nycocado/wash-buddy/media/milestone-2/bom-d01.xlsx

Ref. Fabricante | Descrição | Categoria | Quant. | Preço un. | Sub-total | Distribuidor | URL | Dimensão (mm)
ESP32-C3 | Microcontrolador ESP32-C3 | Microcontrolador | 1 | €5.58 | €5.58 | Amazon | https://www.amazon.es/-/pt/dp/B0DMNBWTFD | 22,5 x 18
BF350-3AA | Sensor de Tensão Variável - Strain Gauges | Sensor | 10 | €1.09 | €10.86 | Amazon | https://www.amazon.es/-/pt/dp/B07TVHSKD1 | 7,1 x 4,5
742548981693 | Amplificador HX711 | Conversor Analógico-Digital | 1 | €5.07 | €5.07 | Amazon | https://www.amazon.es/-/pt/dp/B07DK1SRPM (https://www.amazon.es/-/pt/dp/B07DK1SRPM/ref=sr_1_10?s=industrial) | 24 x 16
26 | Giroscópio/Acelerómetro MPU-6050 | Sensor | 1 | €4.57 | €4.57 | Amazon | https://www.amazon.es/-/pt/dp/B0CW5144RT (https://www.amazon.es/-/pt/dp/B0CW5144RT?s=industrial) | 20 x 15
096-7357 | Motor de Vibração de Pastilha 3v | Atuadores | 1 | €1.09 | €1.09 | Mauser | https://mauser.pt/096-7357 (https://mauser.pt/096-7357/mini-motor-de-vibracao-de-pastilha-3v-10x2mm) | Ø 10 x 2
035-5293 | Bateria 3.7V 1200mAh Li-Po | Alimentação | 1 | €7.45 | €7.45 | Mauser | https://mauser.pt/035-5293 (https://mauser.pt/035-5293/bateria-3-7v-1200mah-li-po-34x40x8-8mm) | 34 x 40 x 8,8
B0D8Q7NG96 | Módulo de Carregamento de Bateria 5V | Carregador de Bateria | 1 | €5.37 | €5.37 | Amazon | https://www.amazon.es/-/pt/dp/B0D8Q7NG96 (https://www.amazon.es/-/pt/dp/B0D8Q7NG96/ref=sr_1_6) | 25 x 19
R915 | USB-C Fêmea Resistênte a Água | USB-C Entrada | 1 | €1.25 | €1.25 | Amazon | https://www.amazon.es/-/pt/dp/B0CDBZZQBZ (https://www.amazon.es/-/pt/dp/B0CDBZZQBZ/ref=sr_1_3) | 25 x 19 x 10
BJ-RS-25VALUES-1000PCS | Resistor 1kΩ | Eletrônica | 1 | €0.01 | €0.01 | Amazon | https://www.amazon.es/-/pt/dp/B08FD1XVL6 (https://www.amazon.es/-/pt/dp/B08FD1XVL6/ref=sr_1_6) | 7,1 x 4,5
BJ-RS-25VALUES-1000PCS | Resistor 10kΩ | Eletrônica | 1 | €0.01 | €0.01 | Amazon | https://www.amazon.es/-/pt/dp/B08FD1XVL6 (https://www.amazon.es/-/pt/dp/B08FD1XVL6/ref=sr_1_6) | 6,5 x 2,3
004-0601 | Capacitor 10μF | Eletrônica | 1 | €0.18 | €0.18 | Mauser | https://mauser.pt/004-0601 (https://mauser.pt/004-0601/condensador-electrolitico-10uf-25v-85-5x11mm) | < 5 mm de diâmetro
007-0205 | Diodo Comutação 100V 200mA | Eletrônica | 1 | €0.09 | €0.09 | Mauser | https://mauser.pt/007-0205 (https://mauser.pt/007-0205/diodo-comutacao-100v-200ma-1n4148-sod27-do-35) | 6,5 x 2,3
002-0093 | Transistor 2N2222A | Eletrônica | 1 | €0.69 | €0.69 | Mauser | https://mauser.pt/002-0093 (https://mauser.pt/002-0093/transistor-2n2222a-to92) | 4,5 x 4,5
096-8739 | Módulo Step-Up XL6009 | Alimentação | 1 | €1.96 | €1.96 | Mauser | https://mauser.pt/096-8739 (https://mauser.pt/096-8739/modulo-step-up-boost-ajustavel-xl6009-5-35v-4a) | 49 x 23,5 x 12,5
096-8736 | Display LCD OLED 0,91" 128x32 | Display | 1 | €3.46 | €3.46 | Mauser | https://mauser.pt/096-8736 | 38 x 12
 |  |  |  | Sub-Total | €47.65
 |  |  |  | Total | €47.65
