nycocado/wash-buddy/media/milestone-2/bom-d02.xlsx

Ref. Fabricante | Descrição | Categoria | Quant. | Preço un. | Sub-total | Distribuidor | URL
‎AM03DE-GXFB0014-005 | Microcontrolador ESP32-WROOM-32 | Microcontrolador | 1 | €7.11 | €7.11 | Amazon | https://www.amazon.es/-/pt/dp/B0D9BTQRYT (https://www.amazon.es/-/pt/dp/B0D9BTQRYT/ref=sr_1_6)
096-0378 | MP3 Player DFR0768 | MP3 Player | 1 | €10.20 | €10.20 | Mauser | https://mauser.pt/096-0378
001726aa241125qmaneu | Alto-falante QUARKZMAN 4 Pack 2W 4ohm | Alto-falante | 2 | €1.98 | €3.96 | Amazon | https://www.amazon.es/-/pt/dp/B0DS6F2LS7 (https://www.amazon.es/-/pt/dp/B0DS6F2LS7/ref=sr_1_14)
ELA2467 | 1.3 inch TFT LCD Display | TFT LCD Display | 1 | €6.99 | €6.99 | Amazon | https://www.amazon.es/-/pt/dp/B09Z299F3Q
096-8739 | Step Up Booster XL6009 | Módulo Step-up | 1 | €1.69 | €1.69 | Mauser | https://mauser.pt/096-8739 (https://mauser.pt/096-8739/modulo-step-up-boost-ajustavel-xl6009-5-35v-4a)
B1183397 | Bateria 3.7V 1200mAh Li-Po | Bateria | 1 | €7.45 | €7.45 | Amazon | https://mauser.pt/035-5293
B0D8Q7NG96 | Módulo de Carregamento de Bateria 5V | Carregador de Bateria | 1 | €5.37 | €5.37 | Amazon | https://www.amazon.es/-/pt/dp/B0D8Q7NG96 (https://www.amazon.es/-/pt/dp/B0D8Q7NG96/ref=sr_1_6)
R915 | USB-C Fêmea Resistênte a Água | USB-C Entrada | 1 | €1.25 | €1.25 | Amazon | https://www.amazon.es/-/pt/dp/B0CDBZZQBZ (https://www.amazon.es/-/pt/dp/B0CDBZZQBZ/ref=sr_1_3)
095-3621 | Módulo Leitor de Cartões Micro-SD | Cartão SD | 1 | €1.70 | €1.70 | Mauser | https://mauser.pt/095-3621 (https://mauser.pt/095-3621/joy-it-com-msd-modulo-leitor-de-cartoes-micro-sd-spi)
095-5078 | Módulo Sensor Hall | Sensor Hall | 7 | €1.45 | €10.15 | Mauser | https://mauser.pt/095-5078
 | 60 Ímãs de Neodímio 5 x 3 mm | Imãs | 1 | €5.65 | €5.65 | Amazon | https://www.amazon.es/-/pt/dp/B0CPHXZ8YJ
 |  |  |  | Sub-Total | €61.52
 |  |  |  | Total | €61.52
