nycocado/wash-buddy/media/milestone-2/bom-d03.xlsx

Ref. Fabricante | Descrição | Categoria | Quant. | Preço un. | Sub-total | Distribuidor | URL
‎AM03DE-GXFB0014-005 | Microcontrolador ESP32-WROOM-32 | Microcontrolador | 1 | €7.11 | €7.11 | Amazon | https://www.amazon.es/-/pt/dp/B0D9BTQRYT (https://www.amazon.es/-/pt/dp/B0D9BTQRYT/ref=sr_1_6)
096-0378 | MP3 Player DFR0768 | MP3 Player | 1 | €10.20 | €10.20 | Mauser | https://mauser.pt/096-0378
001726aa241125qmaneu | Alto-falante QUARKZMAN 4 Pack 2W 4ohm | Alto-falante | 2 | €1.98 | €3.96 | Amazon | https://www.amazon.es/-/pt/dp/B0DS6F2LS7 (https://www.amazon.es/-/pt/dp/B0DS6F2LS7/ref=sr_1_14)
096-8831 | Motor de Passo 5VDC com Driver ULN2003 | Motor de Passo | 1 | €3.99 | €3.99 | Mauser | https://mauser.pt/096-8831
096-8739 | Step Up Booster XL6009 | Módulo Step-up | 1 | €1.69 | €1.69 | Mauser | https://mauser.pt/096-8739 (https://mauser.pt/096-8739/modulo-step-up-boost-ajustavel-xl6009-5-35v-4a)
B1183397 | Bateria 3.7V 2200mAh | Bateria | 1 | €8.30 | €8.30 | Amazon | https://www.amazon.es/-/pt/dp/B0DJY8CWGR
B0D8Q7NG96 | Módulo de Carregamento de Bateria 5V | Carregador de Bateria | 1 | €5.37 | €5.37 | Amazon | https://www.amazon.es/-/pt/dp/B0D8Q7NG96 (https://www.amazon.es/-/pt/dp/B0D8Q7NG96/ref=sr_1_6)
R915 | USB-C Fêmea Resistênte a Água | USB-C Entrada | 1 | €1.25 | €1.25 | Amazon | https://www.amazon.es/-/pt/dp/B0CDBZZQBZ (https://www.amazon.es/-/pt/dp/B0CDBZZQBZ/ref=sr_1_3)
WLR-01 | WS2812B Faixa LED | LED | 1 | €12.19 | €12.19 | Amazon | https://www.amazon.es/-/pt/dp/B0BTV9TD36
 |  |  |  | Sub-Total | €54.06
 |  |  |  | Total | €54.06
