nycocado/wash-buddy/media/milestone-2/bom-d04.xlsx

Ref. Fabricante | Descrição | Categoria | Quant. | Preço un. | Sub-total | Distribuidor | URL
‎AM03DE-GXFB0014-005 | Microcontrolador ESP32-WROOM-32 | Microcontrolador | 1 | 7.11 | 7.11 | Amazon | https://www.amazon.es/-/pt/dp/B0D9BTQRYT (https://www.amazon.es/-/pt/dp/B0D9BTQRYT/ref=sr_1_6)
096-8517 | Leitor RFID RC522 | Sensor RFID | 1 | 1.96 | 1.96 | Mauser | https://mauser.pt/096-8517
096-0378 | MP3 Player DFR0768 | MP3 Player | 1 | 10.2 | 10.2 | Mauser | https://mauser.pt/096-0378 (https://mauser.pt/096-0378/dfrobot-dfr0768-mini-modulo-leitor-de-mp3-c-128mb-usb-c-2-barras-de-pinos-fermion-dfplayer-pro)
001726aa241125qmaneu | Alto-falante QUARKZMAN 4 Pack 2W 4ohm | Alto-falante | 2 | 1.98 | 3.96 | Amazon | https://www.amazon.es/-/pt/dp/B0DS6F2LS7 (https://www.amazon.es/-/pt/dp/B0DS6F2LS7/ref=sr_1_14)
4675221 | Micro Servo Motor | Atuador Eletrico | 3 | 2.663333333 | 7.99 | Amazon | https://www.amazon.es/-/pt/dp/B0DSPYZ4SH (https://www.amazon.es/-/pt/dp/B0DSPYZ4SH/ref=sr_1_4)
‎rfid sticker | Adesivo RFID 13.56 MHz (30x15mm) | Adesivo RFID | 5 | 0.608 | 3.04 | Amazon | https://www.amazon.es/-/pt/dp/B08NJKTPR8 (https://www.amazon.es/-/pt/dp/B08NJKTPR8/ref=sr_1_5)
B1183397 | Bateria 3.7V 2200mAh | Bateria | 2 | 8.3 | 16.6 | Amazon | https://www.amazon.es/-/pt/dp/B0DJY8CWGR (https://www.amazon.es/-/pt/dp/B0DJY8CWGR/ref=sr_1_2)
096-8753 | Tela OLED 1.3" 128x64 | Display | 1 | 6.94 | 6.94 | Mauser | https://mauser.pt/096-8753 (https://mauser.pt/096-8753/modulo-ecra-oled-de-1-3-para-arduino-azul)
R915 | USB-C Fêmea Resistênte a Água | USB-C Entrada | 1 | 1.25 | 1.25 | Amazon | https://www.amazon.es/-/pt/dp/B0CDBZZQBZ (https://www.amazon.es/-/pt/dp/B0CDBZZQBZ/ref=sr_1_3)
095-1366 | Módulo Carregador de Bateria DFR1026 | Carregamento | 1 | 3.9 | 3.9 | Mauser | https://mauser.pt/095-1366 (https://mauser.pt/095-1366/dfrobot-dfr1026-modulo-carregador-de-bateria-li-ion-2a-c-bms-e-output-5v)
T353 | Suporte de Bateria | Suporte | 2 | 1.016 | 2.032 | Amazon | https://www.amazon.es/-/pt/dp/B08CY56M98
002-1190 | Transistor IRLZ44N | Eletrônica | 1 | 1.14 | 1.14 | Mauser | https://mauser.pt/002-1190
002-1349 | Transistor 2N7000 | Eletrônica | 1 | 0.15 | 0.15 | Mauser | https://mauser.pt/002-1349
BJ-RS-25VALUES-1000PCS | Resistor 1kΩ | Eletrônica | 3 | 0.01321 | 0.03963 | Amazon | https://www.amazon.es/-/pt/dp/B08FD1XVL6 (https://www.amazon.es/-/pt/dp/B08FD1XVL6/ref=sr_1_6)
BJ-RS-25VALUES-1000PCS | Resistor 10kΩ | Eletrônica | 2 | 0.01321 | 0.02642 | Amazon | https://www.amazon.es/-/pt/dp/B08FD1XVL6 (https://www.amazon.es/-/pt/dp/B08FD1XVL6/ref=sr_1_6)
BJ-RS-25VALUES-1000PCS | Resistor 10Ω | Eletrônica | 4 | 0.01321 | 0.05284 | Amazon | https://www.amazon.es/-/pt/dp/B08FD1XVL6 (https://www.amazon.es/-/pt/dp/B08FD1XVL6/ref=sr_1_6)
004-0601 | Condensador Electrolítico 10uF 25V | Eletrônica | 1 | 0.18 | 0.18 | Mauser | https://mauser.pt/004-0601 (https://mauser.pt/004-0601/condensador-electrolitico-10uf-25v-85-5x11mm)
004-0177 | Condensador Electrolítico 1000uF 35V | Eletrônica | 2 | 0.3 | 0.6 | Mauser | https://mauser.pt/004-0177
004-5086 | Condensador Cerâmico 100nF 50V | Eletrônica | 1 | 0.097 | 0.097 | Mauser | https://mauser.pt/004-5086
031-0028 | Bobina de Indutância Radial 100uH 1700mA | Eletrônica | 1 | 0.7 | 0.7 | Mauser | https://mauser.pt/031-0028
096-6400 | Placa ProtoBoard 50x70mm 432 Furos | Eletrônica | 2 | 0.95 | 1.9 | Mauser | https://mauser.pt/096-6400
 |  |  |  | Sub-Total | 69.86789
 |  |  |  | Total | 69.86789
