nycocado/wash-buddy/media/milestone-1/bom.xlsx

Ref. Fabricante | Descrição | Categoria | Quant. | Preço un. | Sub-total | Distribuidor | URL
ESP32-C3 | Microcontrolador ESP32-C3 | Microcontrolador | 1 | €3.81 | €3.81 | Amazon | https://www.amazon.es/-/pt/dp/B0DS23ML1L/ref=sr_1_6
TS-YM-315 | Sensor de Tensão Variável - Strain Gauges | Sensor | 8 | €1.09 | €8.69 | Amazon | https://www.amazon.es/-/pt/dp/B07TVHSKD1/ref=sr_1_2
IT-NXMMKA‎ | Amplificador HX711 | Conversor Analógico-Digital | 1 | €1.52 | €1.52 | Amazon | https://www.amazon.es/-/pt/dp/B0CSD82H43/ref=sr_1_3?s=industrial
26 | Giroscópio/Acelerómetro MPU-6050 | Sensor | 1 | €4.57 | €4.57 | Amazon | https://www.amazon.es/-/pt/dp/B0CW5144RT/ref=sr_1_7?s=industrial
096-7357 | Motor de Vibração de Pastilha 3v | Atuadores | 1 | €1.09 | €1.09 | Mauser | https://mauser.pt/096-7357/mini-motor-de-vibracao-de-pastilha-3v-10x2mm
DR-YM-296C | Módulo de Carregamento por Indução | Alimentação | 1 | €12.19 | €12.19 | Amazon | https://www.amazon.es/-/pt/dp/B0897KLDB3/ref=sr_1_2
CJMUQHEHH | Adesivo NFC 215 Regravável | Identificação | 1 | €0.18 | €0.18 | Amazon | https://www.amazon.es/-/pt/dp/B0FQWT28LK/ref=sr_1_7
035-5293 | Bateria 3.7V 1200mAh Li-Po | Alimentação | 1 | €7.45 | €7.45 | Mauser | https://mauser.pt/035-5293/bateria-3-7v-1200mah-li-po-34x40x8-8mm
096-6400 | Placa ProtoBoard 50x70mm 432 Furos | Utilitários | 1 | €0.95 | €0.95 | Mauser | https://mauser.pt/096-6400/placa-protoboard-50x70mm-432-furos
BJ-RS-25VALUES-1000PCS | Resistor 1kΩ | Eletrônica | 1 | €0.01 | €0.01 | Amazon | https://www.amazon.es/-/pt/dp/B08FD1XVL6/ref=sr_1_6
BJ-RS-25VALUES-1000PCS | Resistor 10kΩ | Eletrônica | 1 | €0.01 | €0.01 | Amazon | https://www.amazon.es/-/pt/dp/B08FD1XVL6/ref=sr_1_6
004-0601 | Capacitor 10μF | Eletrônica | 1 | €0.18 | €0.18 | Mauser | https://mauser.pt/004-0601/condensador-electrolitico-10uf-25v-85-5x11mm
007-0205 | Diodo Flyback | Eletrônica | 1 | €0.09 | €0.09 | Mauser | https://mauser.pt/007-0205/diodo-comutacao-100v-200ma-1n4148-sod27-do-35
002-0093 | Transistor 2N2222A | Eletrônica | 1 | €0.69 | €0.69 | Mauser | https://mauser.pt/002-0093/transistor-2n2222a-to92
096-8739 | Módulo Step-Up XL6009 | Alimentação | 1 | €1.96 | €1.96 | Mauser | https://mauser.pt/096-8739/modulo-step-up-boost-ajustavel-xl6009-5-35v-4a
 |  |  |  | Sub-Total | €43.40
 |  |  |  | Total | €43.40
