nycocado/wash-buddy/(commit log)

2026-03-03 [docs] add circuit diagrams and reports
    [bom.xlsx]
2026-03-11 [refactor] remove mobile app and restructure documents
    [bom.xlsx]
2026-04-06 [docs] add electronic circuits and final report
2026-04-07 [docs] update bill of materials
    [bom-d01.xlsx, bom-d02.xlsx, bom-d03.xlsx, bom-d04.xlsx]
2026-04-11 [docs] add milestone deliverables and documentation
    [bom-d01.xlsx, bom-d02.xlsx, bom-d03.xlsx, bom-d04.xlsx, bom.xlsx]
2026-07-04 [docs] add banner and PCB layer photos to media
2026-07-04 [docs] rewrite README with banner, PCB layer photos, and PT translation
