nycocado/wash-buddy/(notices)

Notices in the files:
README.md:
License: CC BY-NC 4.0
